VentoTran/HUST_MEASUREMENT_DEVICE/REFERENCE/INA128.jpg

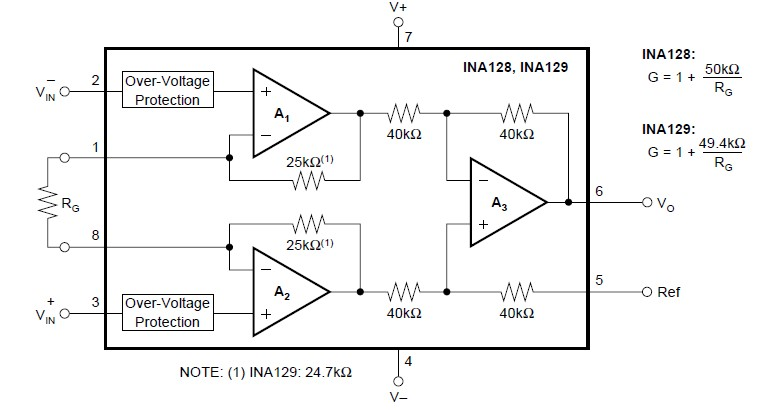
REFERENCE/INA128.jpg
