VentoTran/HUST_MEASUREMENT_DEVICE/REFERENCE/INA128_TMCP.PNG

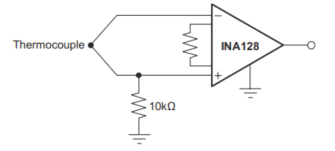
REFERENCE/INA128_TMCP.PNG
