VentoTran/HUST_MEASUREMENT_DEVICE/REFERENCE/Voltage-Temperature-Table.png

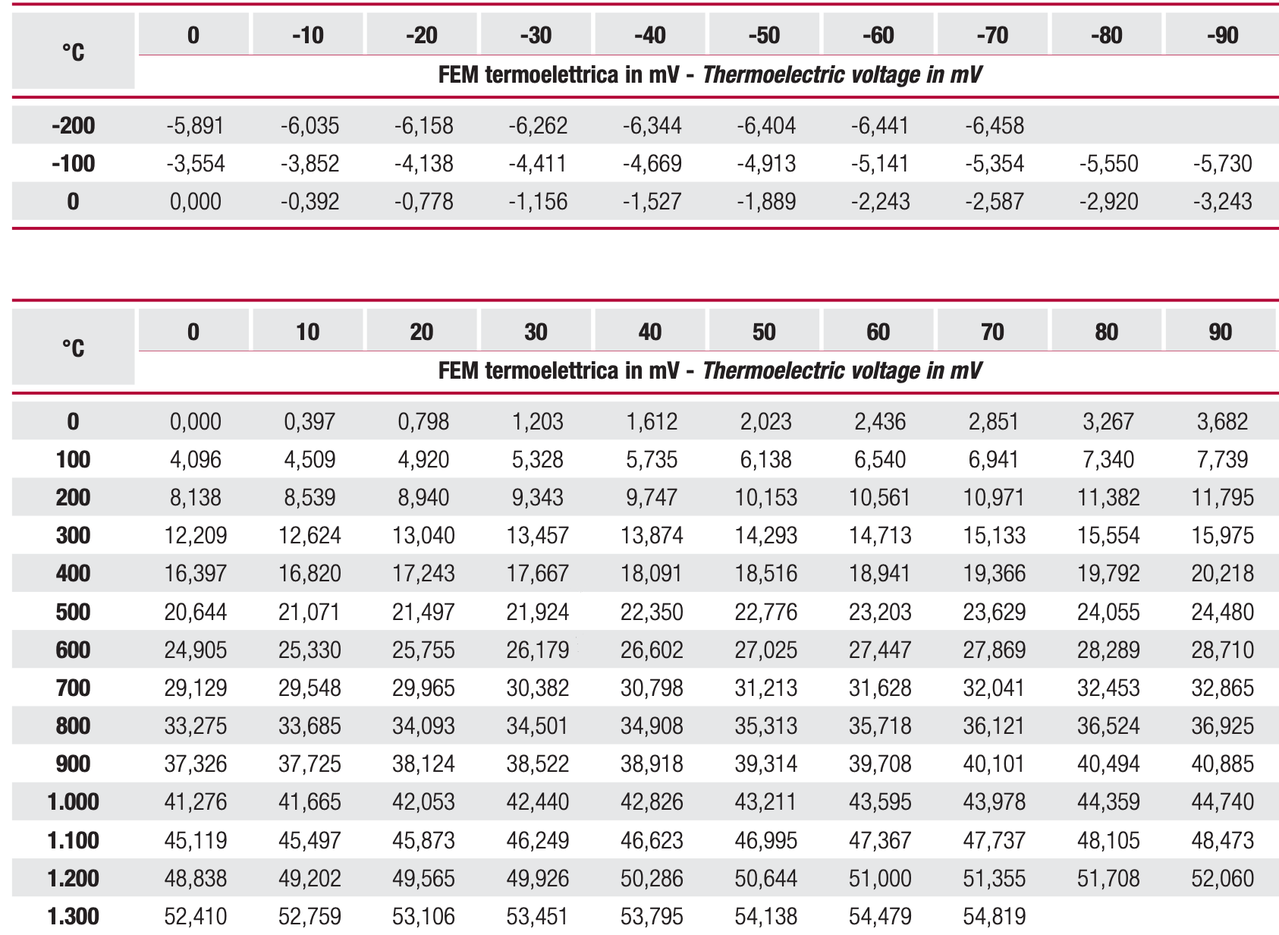
REFERENCE/Voltage-Temperature-Table.png
