VentoTran/HUST_MEASUREMENT_DEVICE/HARDWARE/Temperature_Measurement_Device.xlsx

Designator | Description | Footprint | Value | Quantity
BT1 | SMD Switch 2 pin | SW_SMD_3x2x4 | SW2 | 1
C1, C5 | Capacitor | CAP_SMD_0805 | 33pF | 2
C2, C3, C4, C6, C7, C9, C10, C18, C19 | Capacitor | CAP_SMD_0805 | 100nF | 9
C8 | Polarized Capacitor (Axial) | DIP_C8mm | 10uF | 1
C11, C12 | Ceramic Capacitor | CAP_DIP | 1nF/400v | 2
C13, C14 | Polarized Capacitor (Axial) | DIP_C8mm | 6.8uF/400V | 2
C15 | Varistor | CAP_DIP | 20D471K | 1
C16 | Polarized Capacitor (Axial) | DIP_C8mm | 1000uF/16V | 1
C17 | Polarized Capacitor (Axial) | DIP_C8mm | 470uF/16V | 1
D1 | Diode Schottky 1N4937 | DIP DO-41 | 1N4937 | 1
D2 | Diode Schottky 1N5819 | SMA | SS14 | 1
DB1 | Diode Bridge DB207S | SOP-4 | 1000V-2A | 1
DS1, DS2, DS3 | Single 7 Seg Dipslay | 7SEGS | LED7SEG | 3
FB1, FB2, FB3, FB4 | Ferrit Bead | RES-SMD-0805 | 10R | 4
IC1 | Atmel AT89C52, 8k Byte Flash Memory , 40 Pin | DIP40/W0.6 | AT89C52 | 1
IC2 | ADC IC 10bits | SOP - 8 µMAX | ADC IC 10bits | 1
IC3 | Programmable Shunt Regulator | qto-92 | TL431 | 1
IC4 | Enhanced, Energy Efficient, Low Power Off-line Switcher | DIP8 | TNY264 | 1
J1 | Teminal | KF2-5.08T | KF2 | 1
J2 | Teminal | KF2-5.08 | AC-IN | 1
L1 | Inductor | L-SMD-M-7.3x4.5 | 2.2uF | 1
L2 | Inductor | L-DIP-M-9.5x6 | 100uH | 1
LED1 | LED Single colour Green and Red | LED-0805-Red | LED | 1
M1 | Serially Interfaced, 8-Digit LED Display Driver | DIP24/W0.3 | MAX7219ENG | 1
Q1, Q2, Q3 | NPN 600mW, ECB | SOT23D | 2SC1815 | 3
R1, R5, R6, R7, R9, R13, R14 | Resistor | RES-SMD-0805 | 10k - 1% | 7
R2 | Resistor | RES-SMD-0805 | 24k9 - 1% | 1
R3 | Resistor | RES-SMD-0805 | 102R - 1% | 1
R4 | Resistor | RES-SMD-0805 | 510R - 1% | 1
R8 | Resistor | RES-1/4WD | 200k - 1% | 1
R10 | Resistor | RES-SMD-0805 | 200R - 1% | 1
R11 | Resistor | RES-1WD | 2R/2W - 1% | 1
R12 | Resistor | RES-SMD-0805 | 3.3k- 1% | 1
SW1 | Switch button 2 pin | SW2 | SW | 1
Transf1 | Transformer EE12.7 | Transformer EE12.7 | Transformer EE12.7 | 1
U1 | Temperature Sensor | QTO-92 | LM35 | 1
U2 | Instrumental Operate Amplifier | SOP-8 | INA128P | 1
U3 | Single Opto | DIP4/W0.3 | PC817 | 1
VR1 | Var Resistor | VR | 10k | 1
X1 | Crystal For all Crystal 2pin. | XT2 | 12Mhz | 1
