VentoTran/HUST_MEASUREMENT_DEVICE/HARDWARE/Temperature_Measurement_Device.pdf

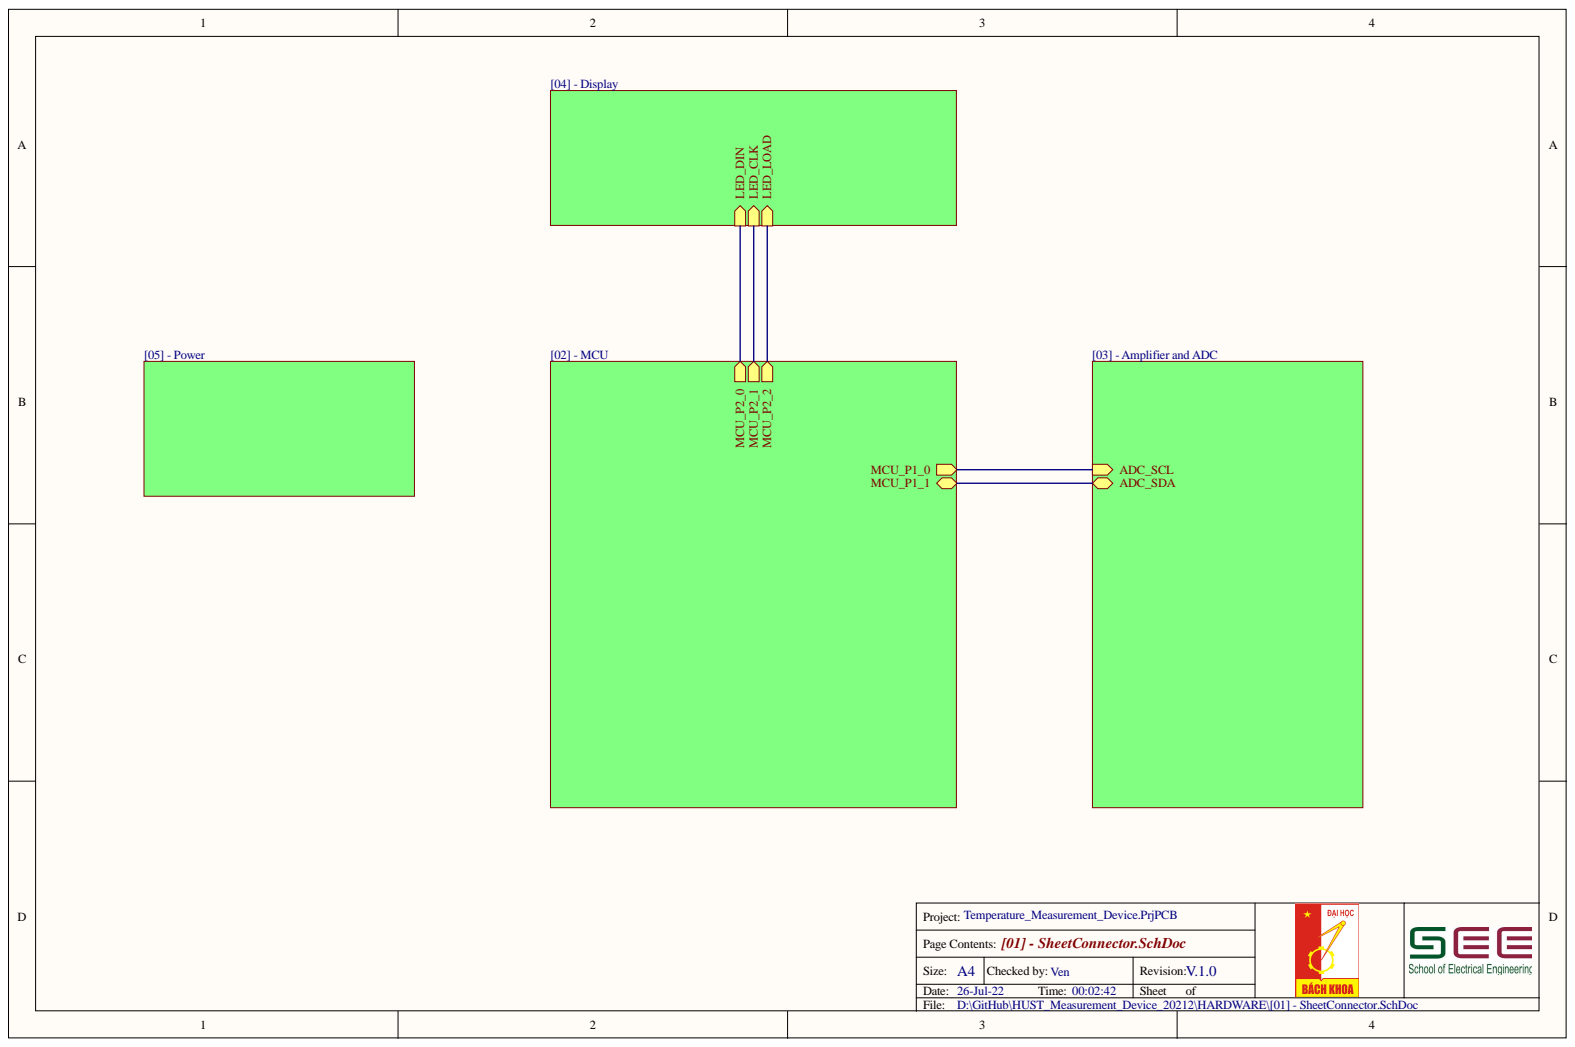
[picture p4: page 1]

A4 Size: | Ven Checked by: | V.1.0 Revision:

Date: 26-Jul-22 Time: 00:02:42 | | Sheet of
File: D:\GitHub\HUST_Measurement_Device_20212\HARDWARE\[01] - SheetConnector.SchDoc

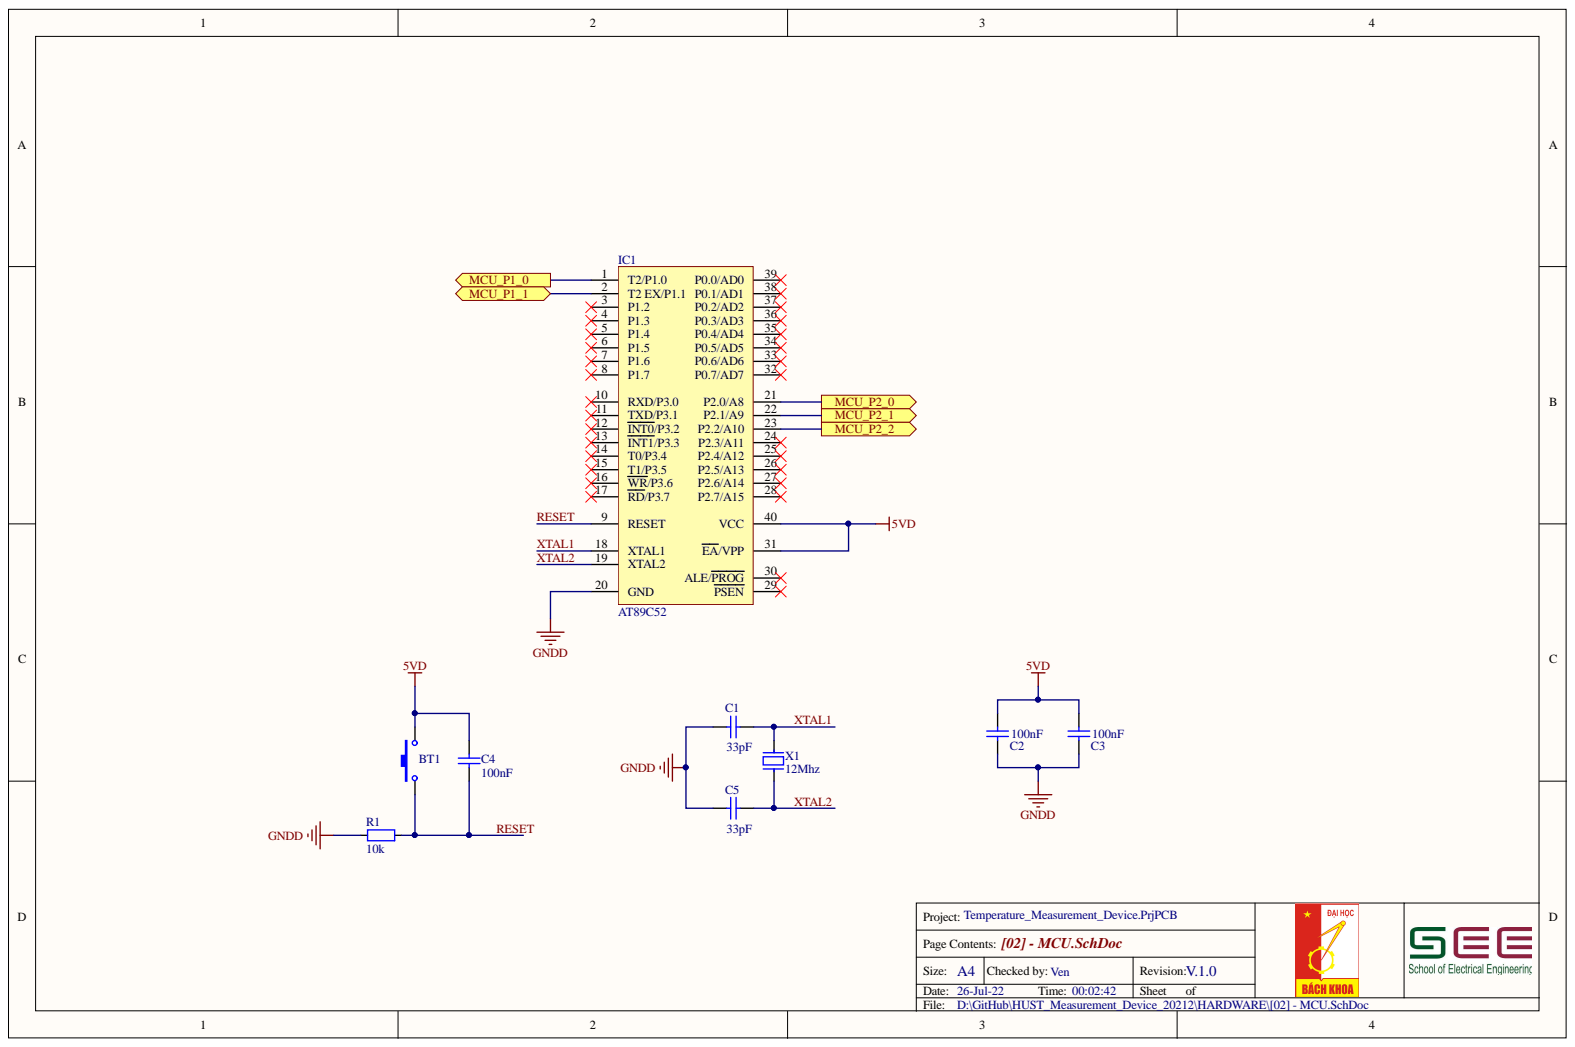
[picture p5: page 2]

A4 Size: | Ven Checked by: | V.1.0 Revision:

Date: 26-Jul-22 Time: 00:02:42 | | Sheet of
File: D:\GitHub\HUST_Measurement_Device_20212\HARDWARE\[02] - MCU.SchDoc

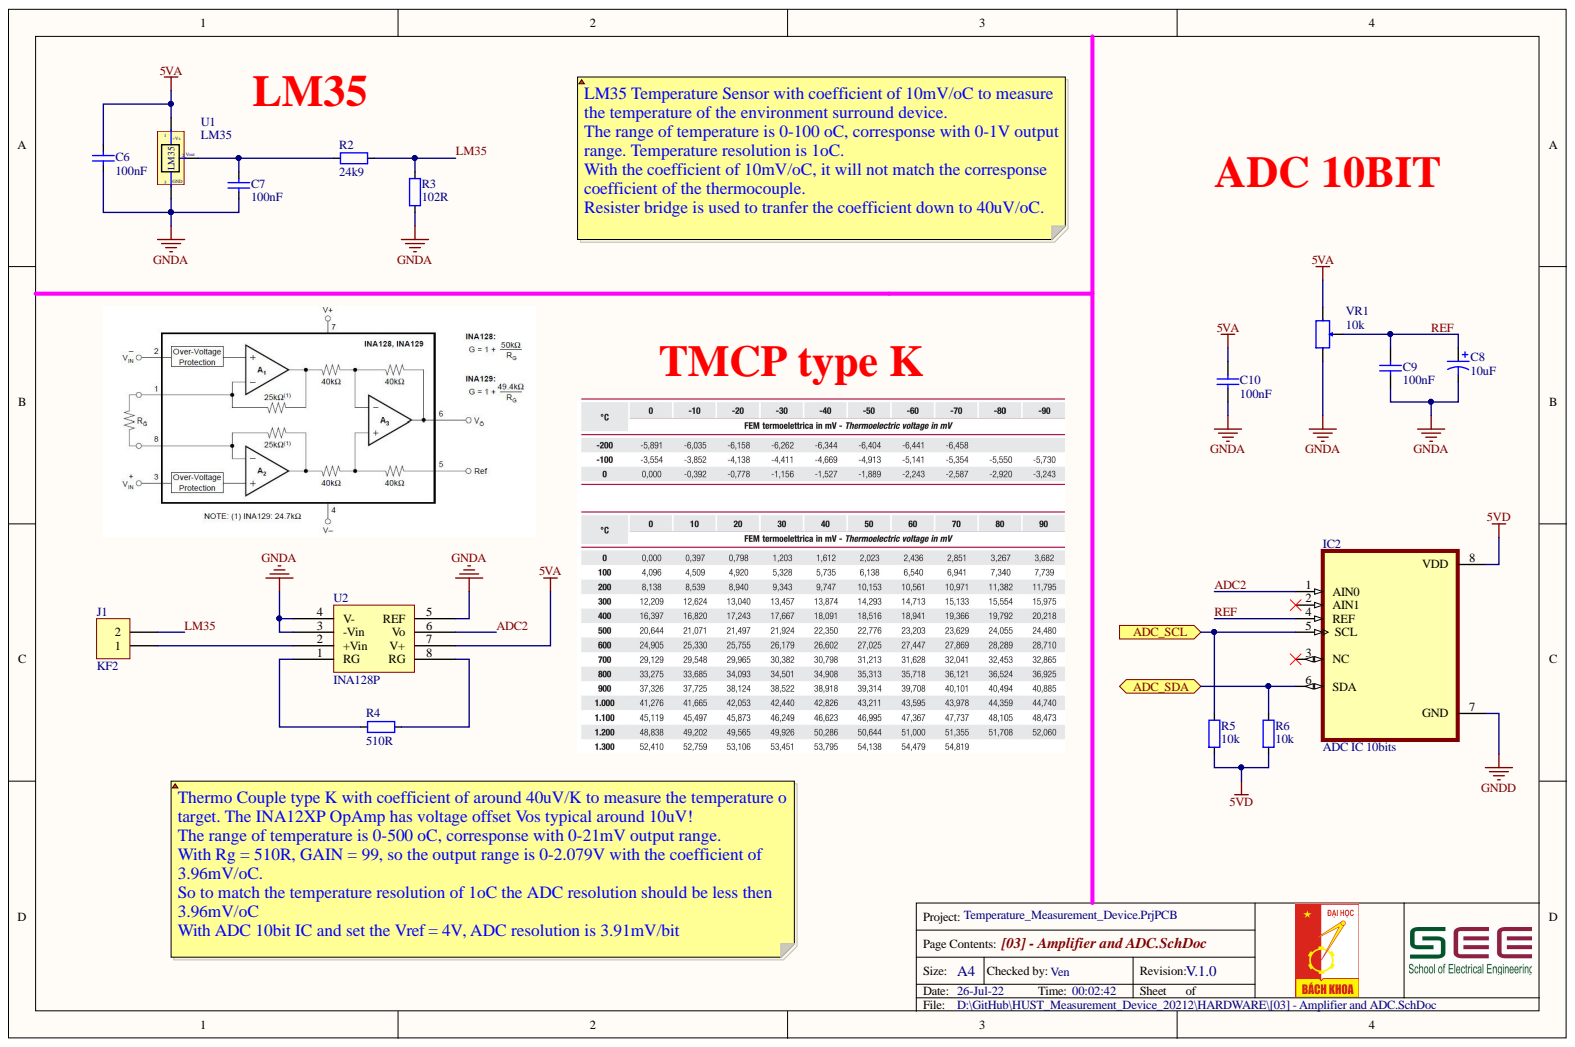
[picture p6: page 3]

LM35 Temperature Sensor with coefficient of 10mV/oC to measure
the temperature of the environment surround device.
The range of temperature is 0-100 oC, corresponse with 0-1V output
range. Temperature resolution is 1oC.
With the coefficient of 10mV/oC, it will not match the corresponse
coefficient of the thermocouple.
Resister bridge is used to tranfer the coefficient down to 40uV/oC.

Thermo Couple type K with coefficient of around 40uV/K to measure the temperature of
target. The INA12XP OpAmp has voltage offset Vos typical around 10uV!
The range of temperature is 0-500 oC, corresponse with 0-21mV output range.
With Rg = 510R, GAIN = 99, so the output range is 0-2.079V with the coefficient of
So to match the temperature resolution of 1oC the ADC resolution should be less then
With ADC 10bit IC and set the Vref = 4V, ADC resolution is 3.91mV/bit

[03] - Amplifier and ADC.SchDoc

A4 Size: | Ven Checked by: | V.1.0 Revision:

Date: 26-Jul-22 Time: 00:02:42 | | Sheet of
File: D:\GitHub\HUST_Measurement_Device_20212\HARDWARE\[03] - Amplifier and ADC.SchDoc

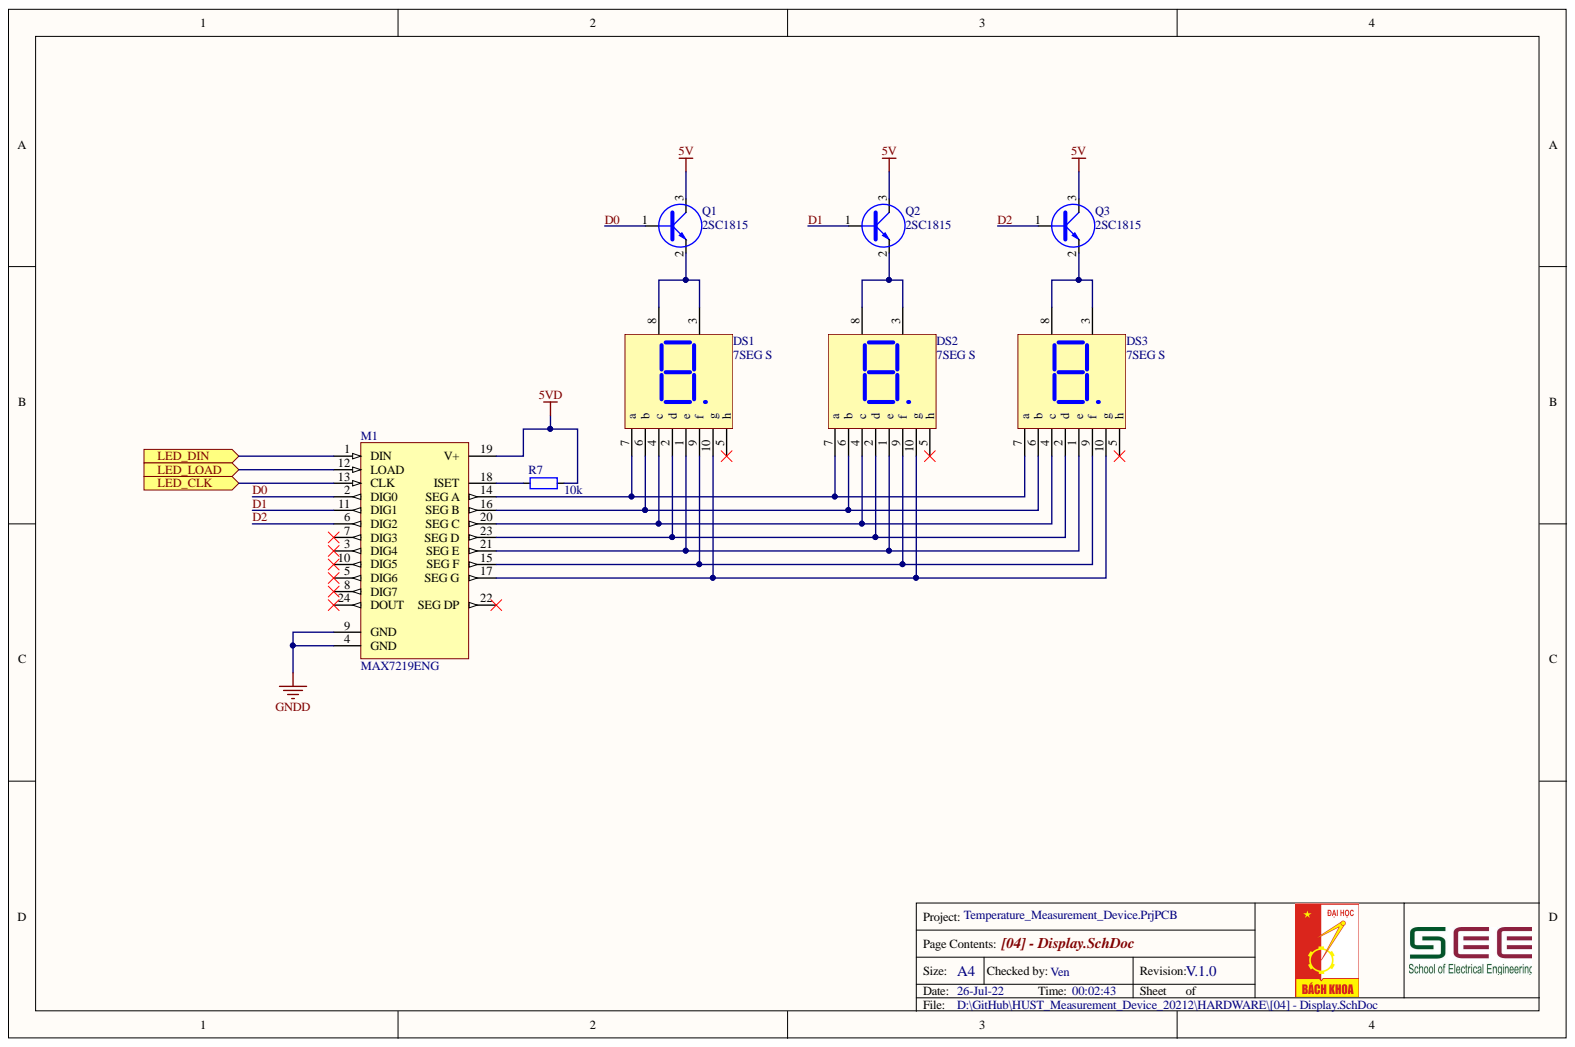
[picture p7: page 4]

A4 Size: | Ven Checked by: | V.1.0 Revision:

Date: 26-Jul-22 Time: 00:02:43 | | Sheet of
File: D:\GitHub\HUST_Measurement_Device_20212\HARDWARE\[04] - Display.SchDoc

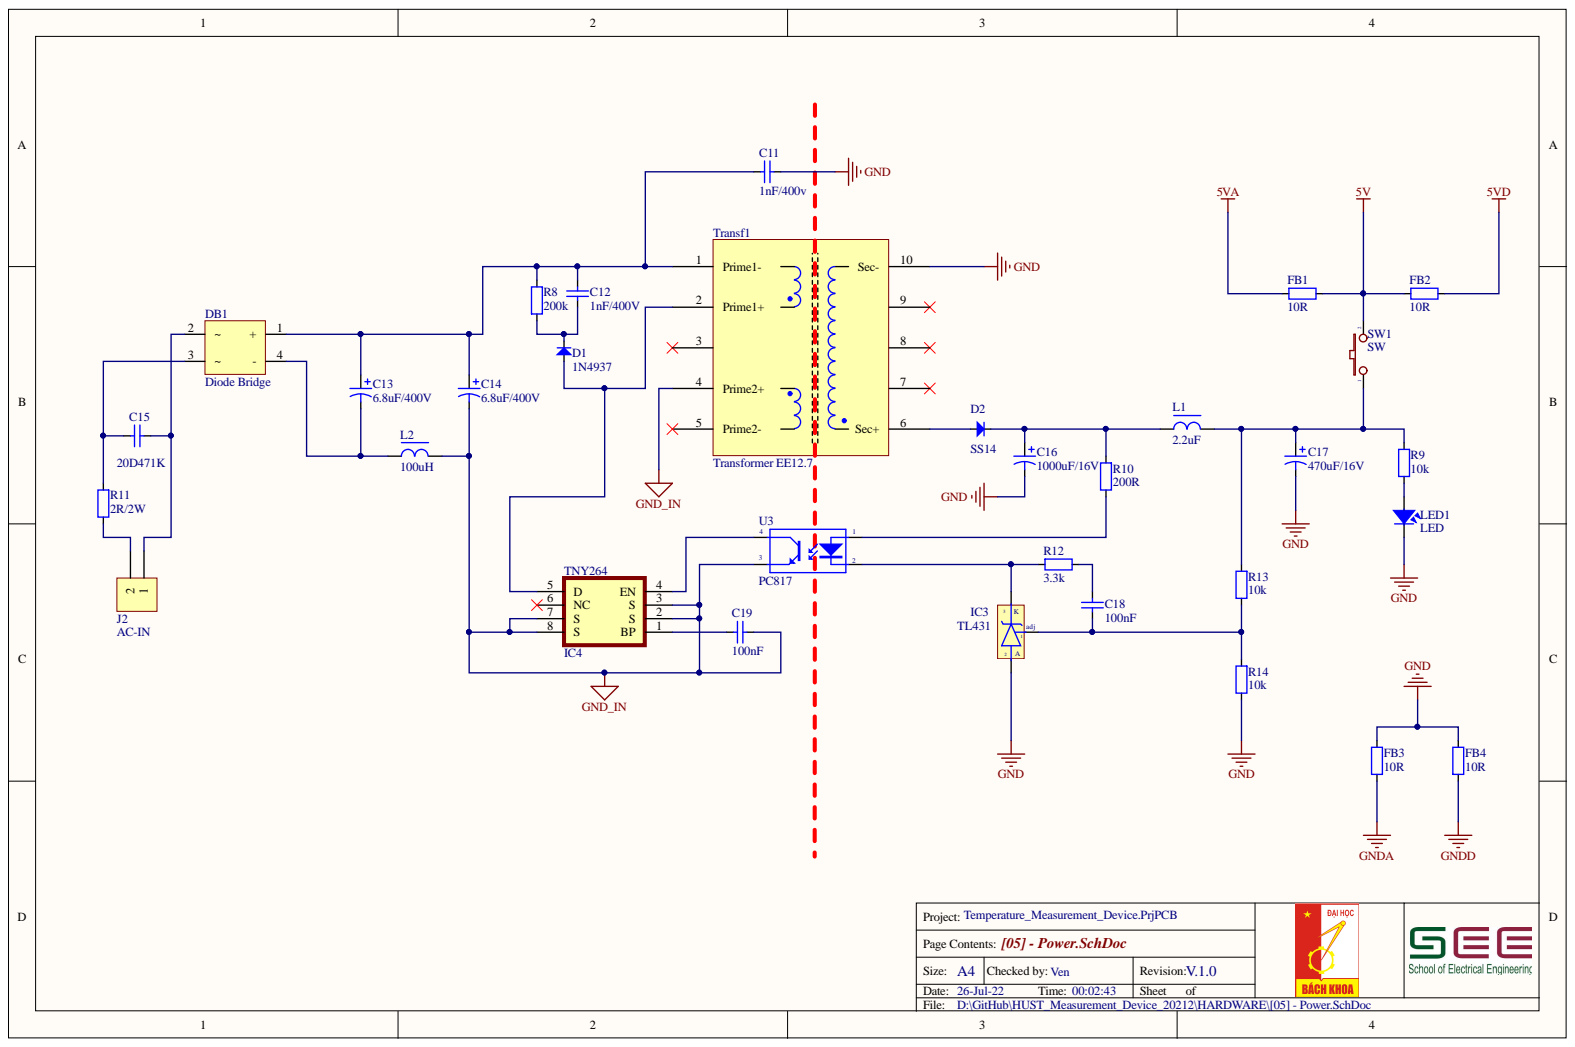
[picture p8: page 5]

Transf1 | 1nF/400v

Prime1- 1

A4 Size: | Ven Checked by: | V.1.0 Revision:

Date: 26-Jul-22 Time: 00:02:43 | | Sheet of
File: D:\GitHub\HUST_Measurement_Device_20212\HARDWARE\[05] - Power.SchDoc

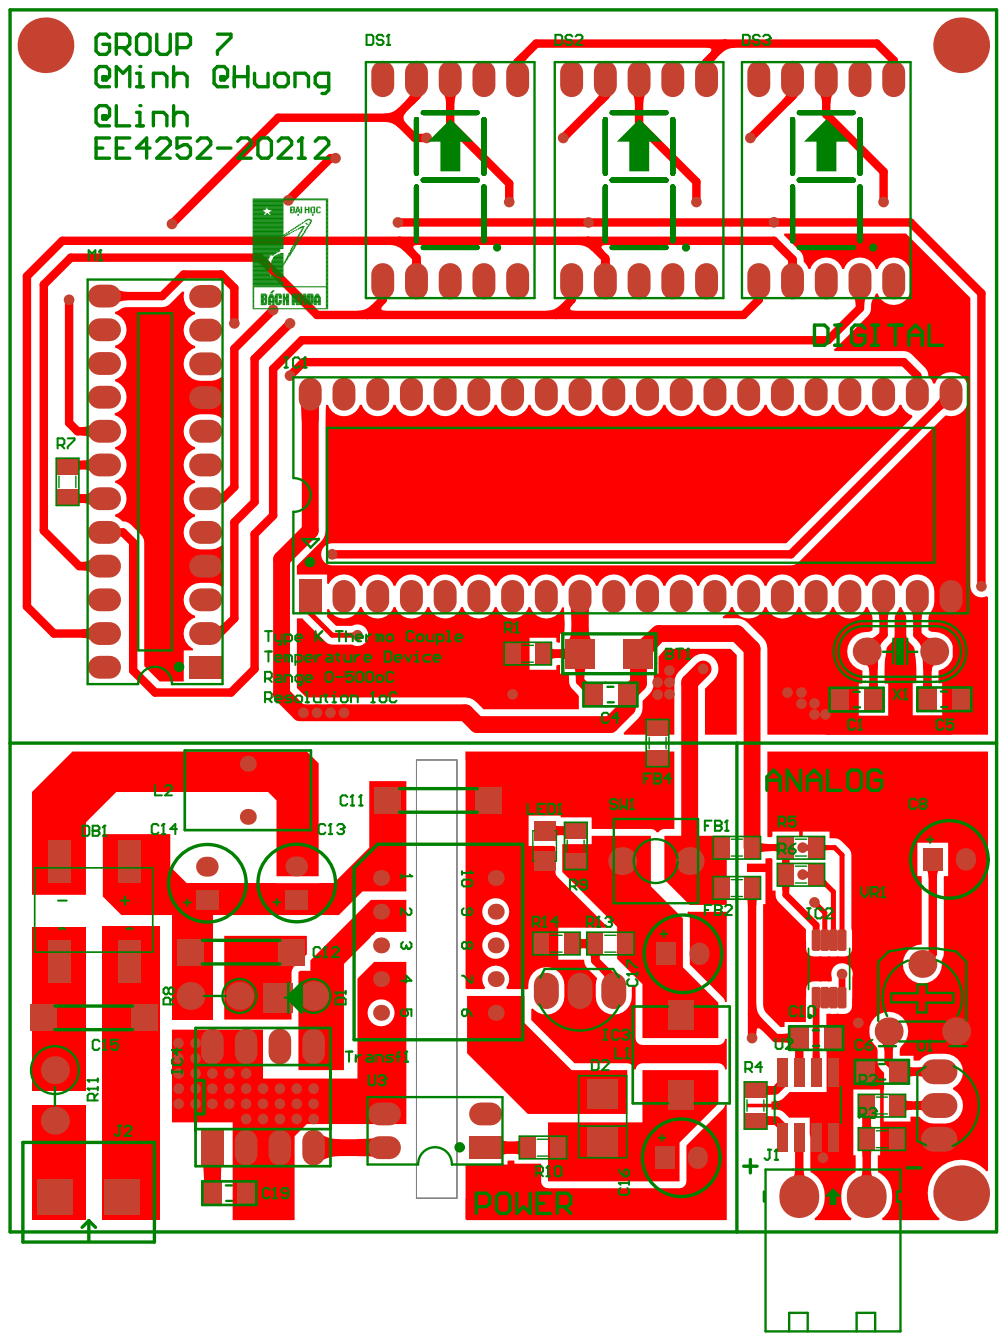
[picture p9: page 6]

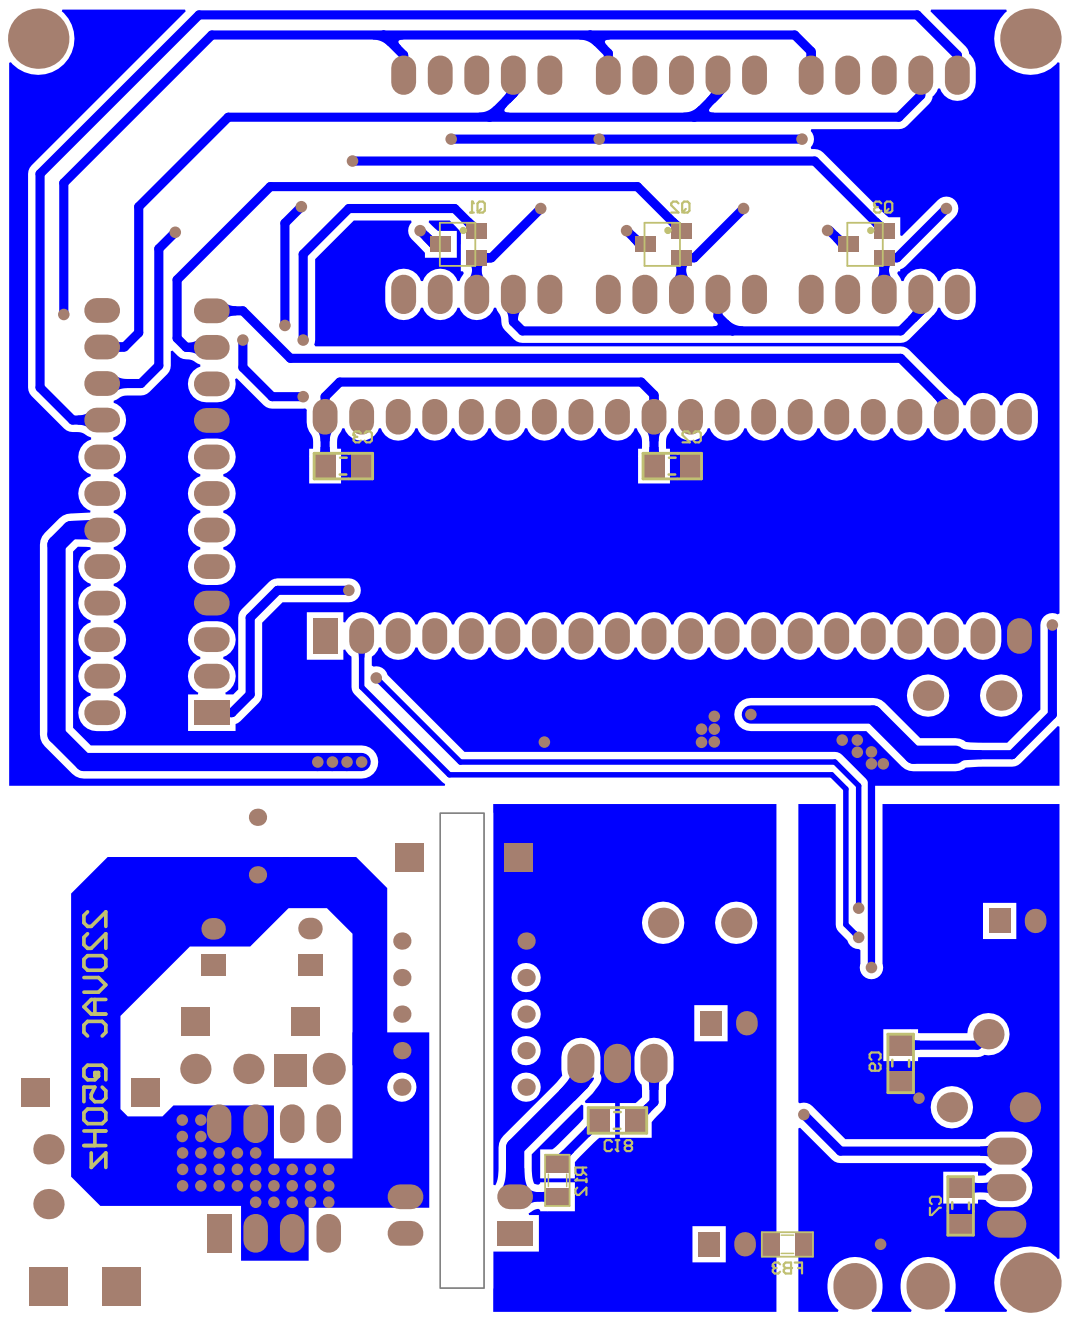
[picture p10: page 7]

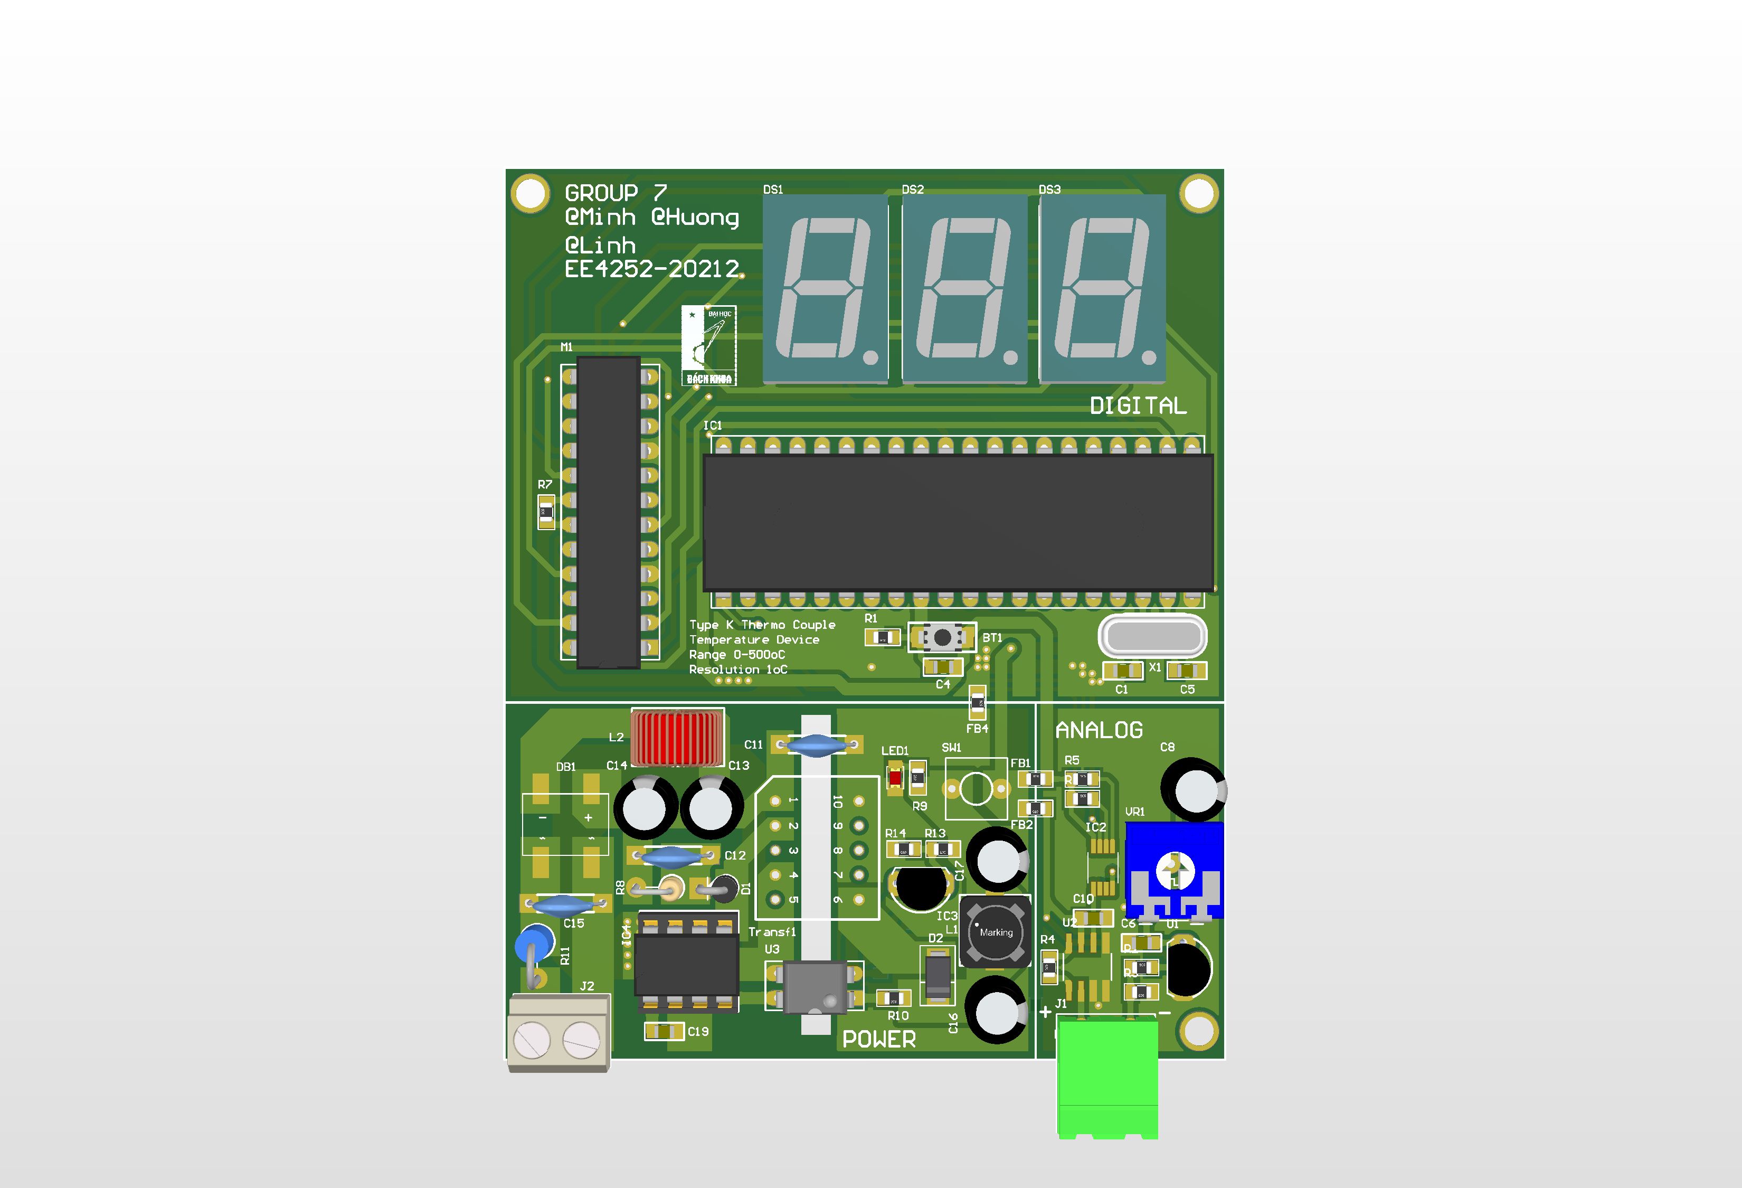
[picture p11: page 8]

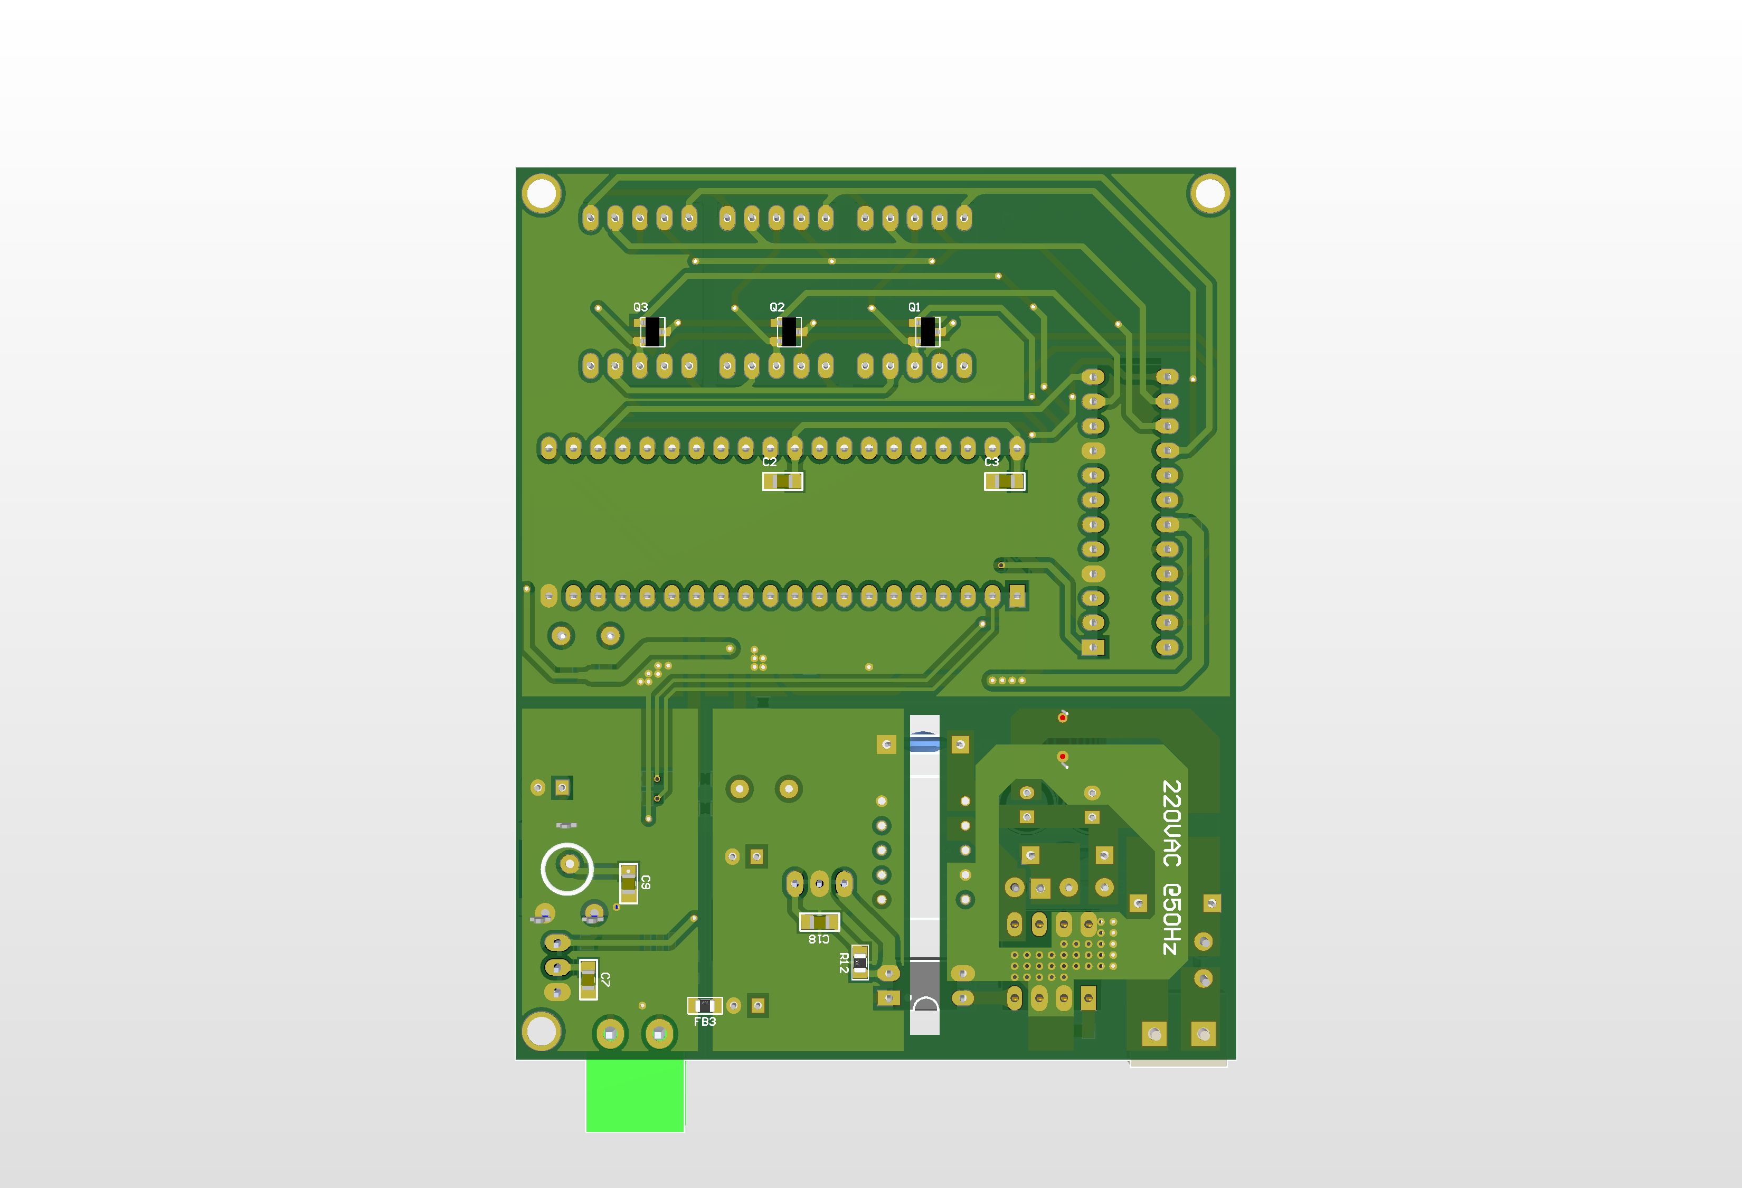
[picture p12: page 9]
