VentoTran/HUST_MEASUREMENT_DEVICE/(list of files, drawings)

Other design files:
HARDWARE/[01] - SheetConnector.SchDoc
HARDWARE/[02] - MCU.SchDoc
HARDWARE/[03] - Amplifier and ADC.SchDoc
HARDWARE/[04] - Display.SchDoc
HARDWARE/[05] - Power.SchDoc
HARDWARE/Temperature_Measurement_Device.PcbDoc
HARDWARE/Temperature_Measurement_Device.PrjPCB
