VentoTran/HUST_MEASUREMENT_DEVICE/(commit log)

2022-07-12 done schematic
    [Temperature_Measurement_Device.PcbDoc, Temperature_Measurement_Device.PrjPCB, [01] - SheetConnector.SchDoc, [02] - MCU.SchDoc, [03] - Amplifier and ADC.SchDoc, [04] - Display.SchDoc, [05] - Power.SchDoc]
2022-07-19 fix schematic, begin PCB layout
    [Temperature_Measurement_Device.PcbDoc, [01] - SheetConnector.SchDoc, [02] - MCU.SchDoc, [03] - Amplifier and ADC.SchDoc, [04] - Display.SchDoc, [05] - Power.SchDoc]
2022-07-25 done 100%, only doc left
    [Temperature_Measurement_Device.PcbDoc, Temperature_Measurement_Device.PrjPCB, Temperature_Measurement_Device.xlsx, [01] - SheetConnector.SchDoc, [02] - MCU.SchDoc, [03] - Amplifier and ADC.SchDoc, [04] - Display.SchDoc, [05] - Power.SchDoc]
